gadzbi123/SimonSaysArduino/README.md

# SimonSaysArduino
Simple Arduino project

Download the movie from project
