gadzbi123/SimonSaysArduino/SimonSays.pptx

## Simon mówi

Projekt wykonany na mikroprocesorze

## Sposób komunikacja z użytkownikiem

- 4 guziki przyjmujące input gracza
- 4 diody wyświetlające kolejność przyciskania następnych klawiszy
- Reset do rozpoczęcia gry od nowa
- Wyświetlacz z prezentowanym wynikiem

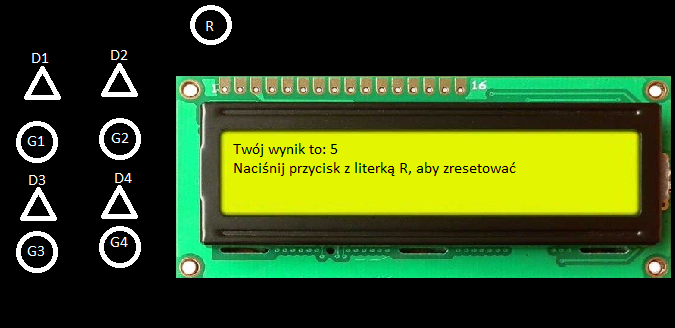
[picture p1: figure]

## Opis interfejsu wejścia/wyjścia

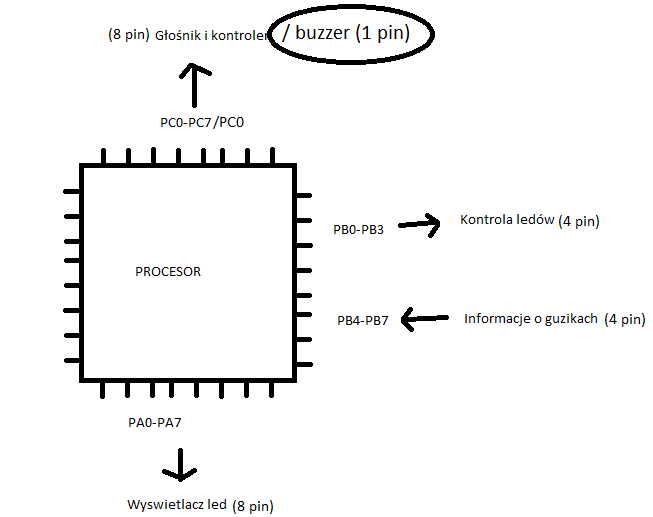
[picture p2: figure]

Najmniejsza ilość pinów potrzebna do wykonania projektu:
8 + 4 + 4 + 1 = 17 pinów

## Wybór mikrokontrolera i technologii

- AT tiny
- 8 KB flash
- Pin count >=17
Ostatecznie At tiny 826 lub AT tiny 48/88.
Technologia płytka drukowana.
Program Microchip Studio.

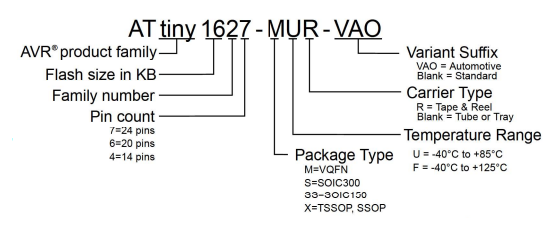
[picture p3: figure]
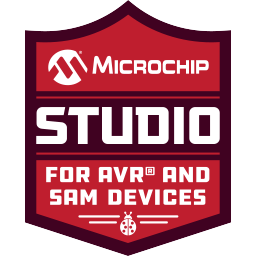
[picture p4: figure]
Microchip Studio for AVR® and SAM Devices | Microchip Technology

## Szacunkowy koszt

PROGRAMER
https://allegro.pl/oferta/programator-atmel-usbasp-usbisp-avr-isp-tasma-7638537342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

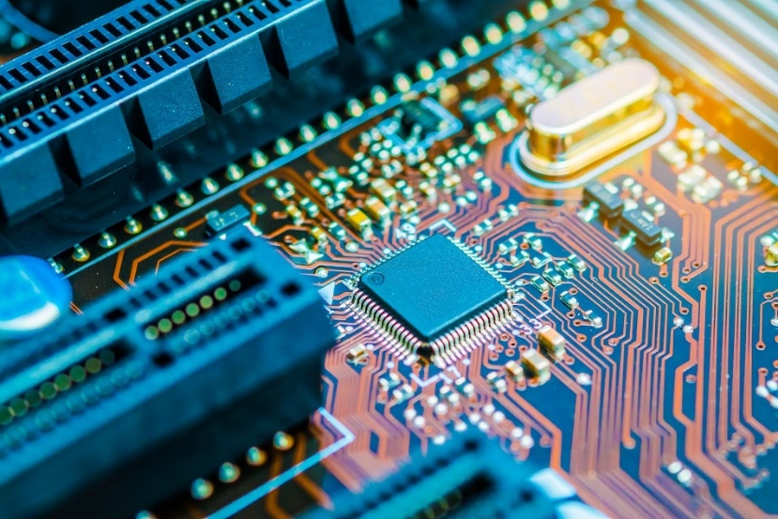
[picture p5: figure]
Could Thermal Analysis Help Develop PCB Design?

Mikroprocesor | 10 zł
Programator | 30 zł
Wyświetlacz led | 10 zł
Wydrukowanie PCB | 30-60 zł
Led, guziki, buzzer | 10 – 20 zł
Suma : | 90 – 130 zł

## Slide 6
