gadzbi123/SimonSaysArduino/board+schematic/attiny.brd

## EAGLE design board+schematic/attiny.brd (2024-04-27)

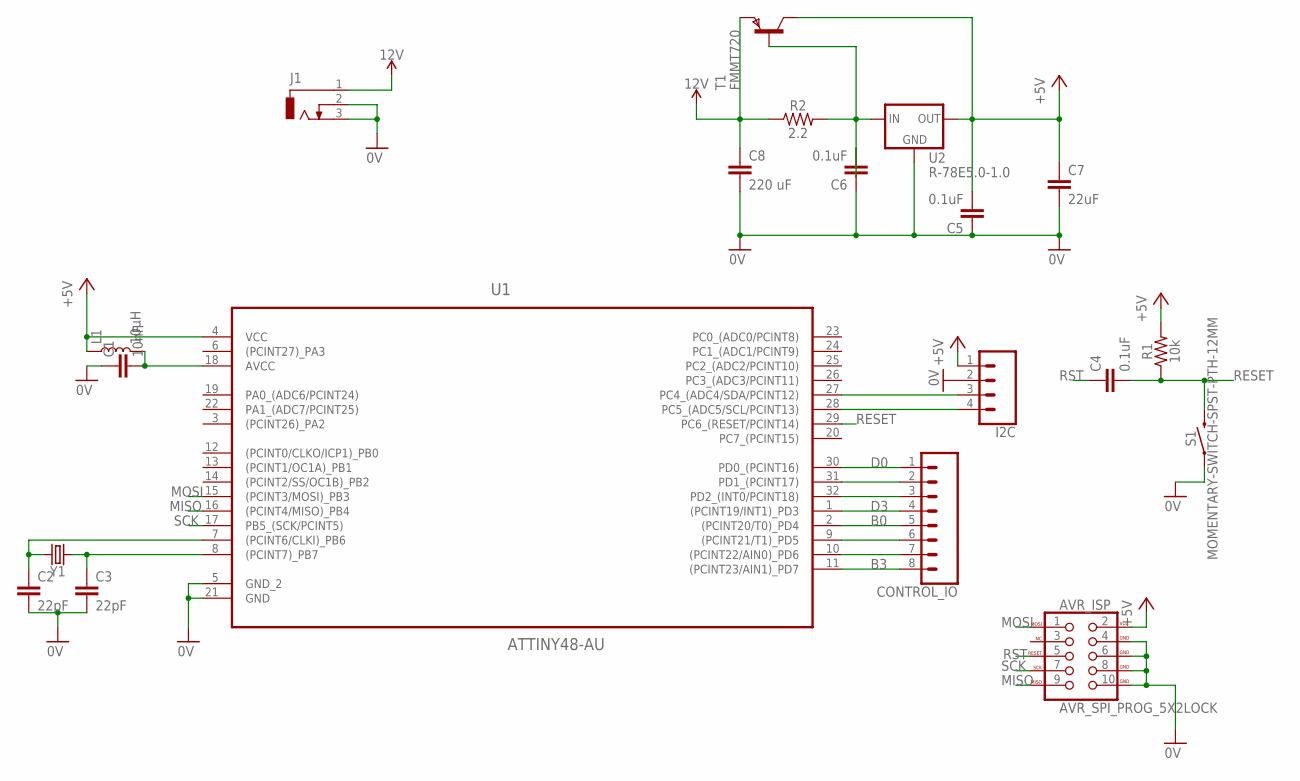
[picture p11: schematic attiny.sch]

Parts:
AVR_ISP: AVR_SPI_PROG_5X2LOCK; 2X5-SHROUDED_LOCK
C1: 10nF; CAP-PTH-10MM
C2, C3: 22pF; 0603
C4, C5, C6: 0.1uF; CAP-PTH-SMALL-KIT
C7: 22uF; 0805
C8: 220 uF; C7.5B5
CONTROL_IO: CONN_08"; 1X08
I2C: CONN_04PTH; 1X04
J1: DCJ0303
L1: 10μH; 0805
R1: 10k; AXIAL-0.3
R2: 2.2; 0603
S1: MOMENTARY-SWITCH-SPST-PTH-12MM; TACTILE_SWITCH_PTH_12MM
T1: FMMT720; SOT-23
U1: ATTINY48-AU; QFP80P900X900X120-32N
U2: R-78E5.0-1.0; DC-DC_CONVERTER_78XX
Y1: CRYSTALPTH-2X6; CRYSTAL-PTH-2X6-CYL

Connections:
0V: AVR_ISP.4 (GND), AVR_ISP.6 (GND), AVR_ISP.8 (GND), AVR_ISP.10 (GND), C1.1, C2.2, C3.2, C5.1, C6.1, C7.2, C8.2, I2C.2, J1.2, J1.3, S1.1, U1.5 (GND_2), U1.21 (GND), U2.GND
12V: C8.1, J1.1, R2.1, T1.2 (E)
+5V: AVR_ISP.2 (VCC), C5.2, C7.1, I2C.1, L1.1, R1.P$2 (2), T1.1 (C), U1.4 (VCC), U2.VOUT (OUT)
B0: CONTROL_IO.5, U1.2 ((PCINT20/T0)_PD4)
B3: CONTROL_IO.8, U1.11 ((PCINT23/AIN1)_PD7)
D0: CONTROL_IO.1, U1.30 (PD0_(PCINT16))
D3: CONTROL_IO.4, U1.1 ((PCINT19/INT1)_PD3)
MISO: AVR_ISP.9 (MISO), U1.16 ((PCINT4/MISO)_PB4)
MOSI: AVR_ISP.1 (MOSI), U1.15 ((PCINT3/MOSI)_PB3)
unnamed: C1.2, L1.2, U1.18 (AVCC)
unnamed: I2C.3, U1.27 (PC4_(ADC4/SDA/PCINT12))
unnamed: I2C.4, U1.28 (PC5_(ADC5/SCL/PCINT13))
unnamed: C2.1, U1.7 ((PCINT6/CLKI)_PB6), Y1.2
unnamed: C3.1, U1.8 ((PCINT7)_PB7), Y1.1
unnamed: C6.2, R2.2, T1.3 (B), U2.VIN (IN)
unnamed: CONTROL_IO.2, U1.31 (PD1_(PCINT17))
unnamed: CONTROL_IO.3, U1.32 (PD2_(INT0/PCINT18))
unnamed: CONTROL_IO.6, U1.9 ((PCINT21/T1)_PD5)
unnamed: CONTROL_IO.7, U1.10 ((PCINT22/AIN0)_PD6)
RESET: C4.2, R1.P$1 (1), S1.3 (2), U1.29 (PC6_(RESET/PCINT14))
RST: AVR_ISP.5 (RESET), C4.1
SCK: AVR_ISP.7 (SCK), U1.17 (PB5_(SCK/PCINT5))

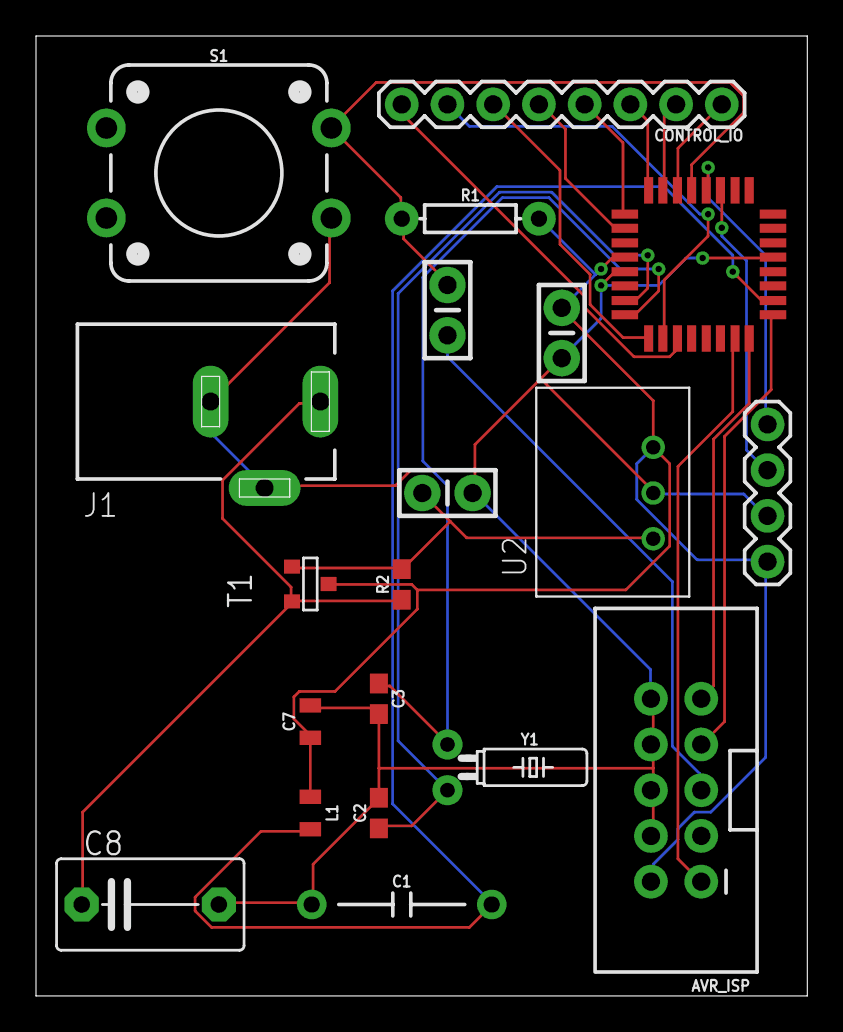
[picture p12: board attiny.brd from above]

Board: 2 copper layers, 42.9 x 53.3 mm, 20 parts (0 on the bottom side), 22 nets.
