gadzbi123/SimonSaysArduino/board+schematic/controller + diods + lcd.brd

## EAGLE design board+schematic/controller + diods + lcd.brd (2024-04-27)

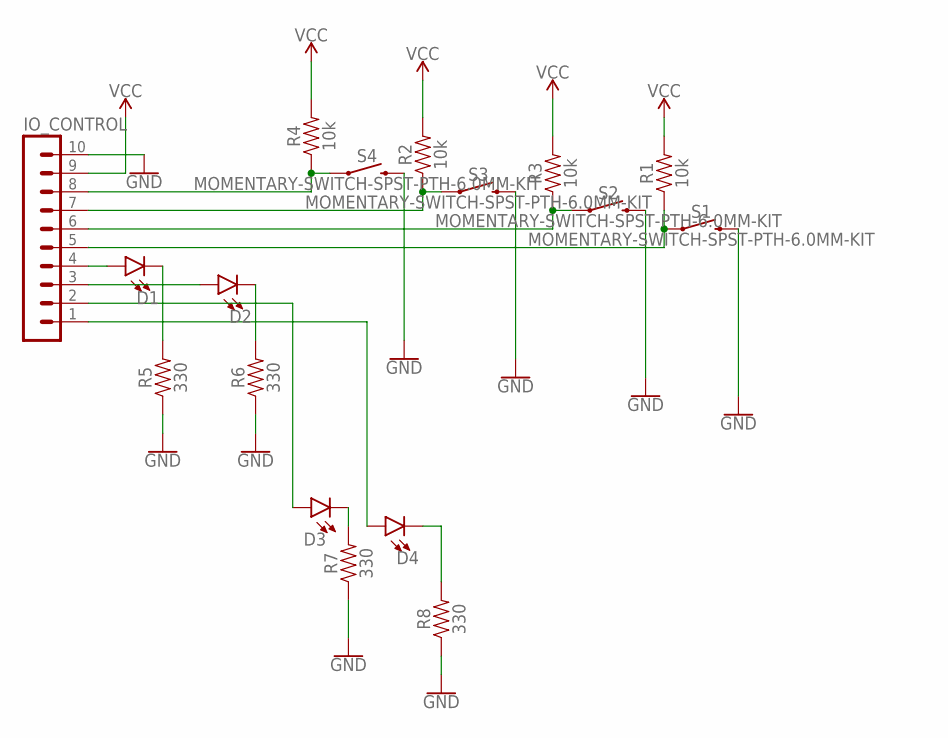
[picture p13: schematic controller + diods + lcd.sch]

Parts:
D1, D2, D3, D4: LED10MM; LED_10MM
IO_CONTROL: MA10-1
R1, R2, R3, R4: 10k; AXIAL-0.3-KIT
R5, R6, R7, R8: 330; AXIAL-0.3
S1, S2, S3, S4: MOMENTARY-SWITCH-SPST-PTH-6.0MM-KIT; TACTILE_SWITCH_PTH_6.0MM_KIT

Connections:
GND: IO_CONTROL.10, R5.P$1 (1), R6.P$1 (1), R7.P$1 (1), R8.P$1 (1), S1.3 (2), S2.3 (2), S3.3 (2), S4.3 (2)
unnamed: IO_CONTROL.6, R3.P$1 (1), S2.1
unnamed: IO_CONTROL.7, R2.P$1 (1), S3.1
unnamed: IO_CONTROL.8, R4.P$1 (1), S4.1
unnamed: D1.A, IO_CONTROL.4
unnamed: D1.C, R5.P$2 (2)
unnamed: D2.A, IO_CONTROL.3
unnamed: D2.C, R6.P$2 (2)
unnamed: D3.A, IO_CONTROL.2
unnamed: D3.C, R7.P$2 (2)
unnamed: D4.A, IO_CONTROL.1
unnamed: D4.C, R8.P$2 (2)
unnamed: IO_CONTROL.5, R1.P$1 (1), S1.1
VCC: IO_CONTROL.9, R1.P$2 (2), R2.P$2 (2), R3.P$2 (2), R4.P$2 (2)

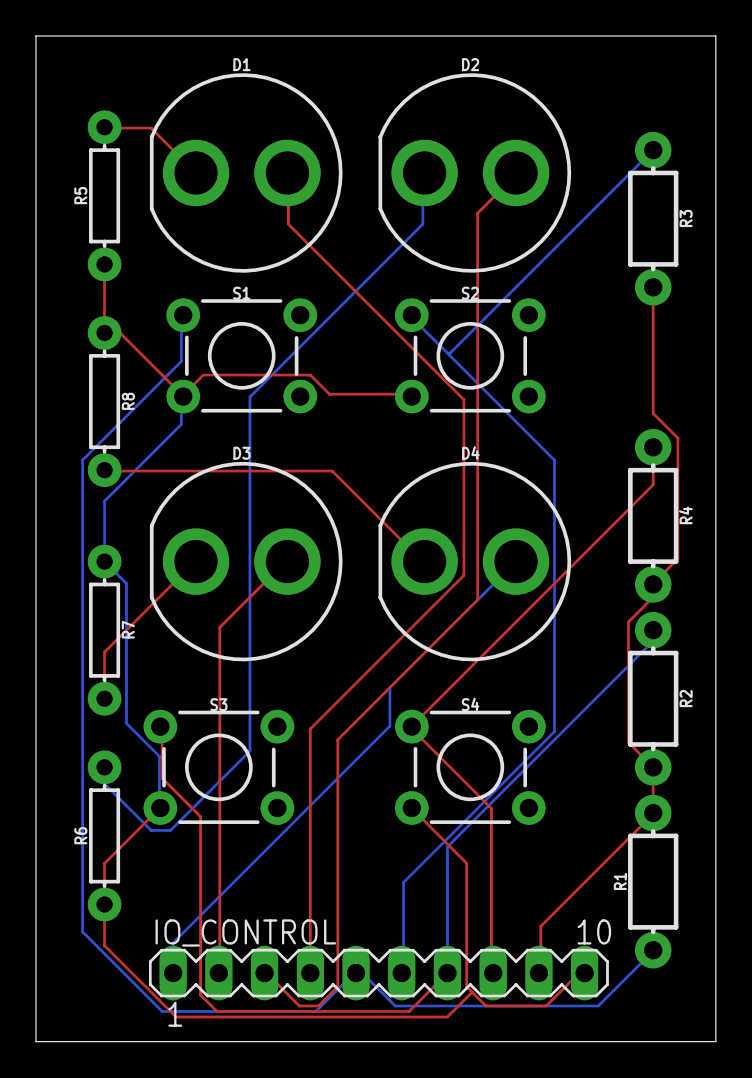
[picture p14: board controller + diods + lcd.brd from above]

Board: 2 copper layers, 37.8 x 55.9 mm, 17 parts (0 on the bottom side), 14 nets.
