gadzbi123/SimonSaysArduino/EAGLE/projects/Atmega2561-16AUR/atmega2561.sch

## EAGLE design EAGLE/projects/Atmega2561-16AUR/atmega2561.sch (2024-04-27)

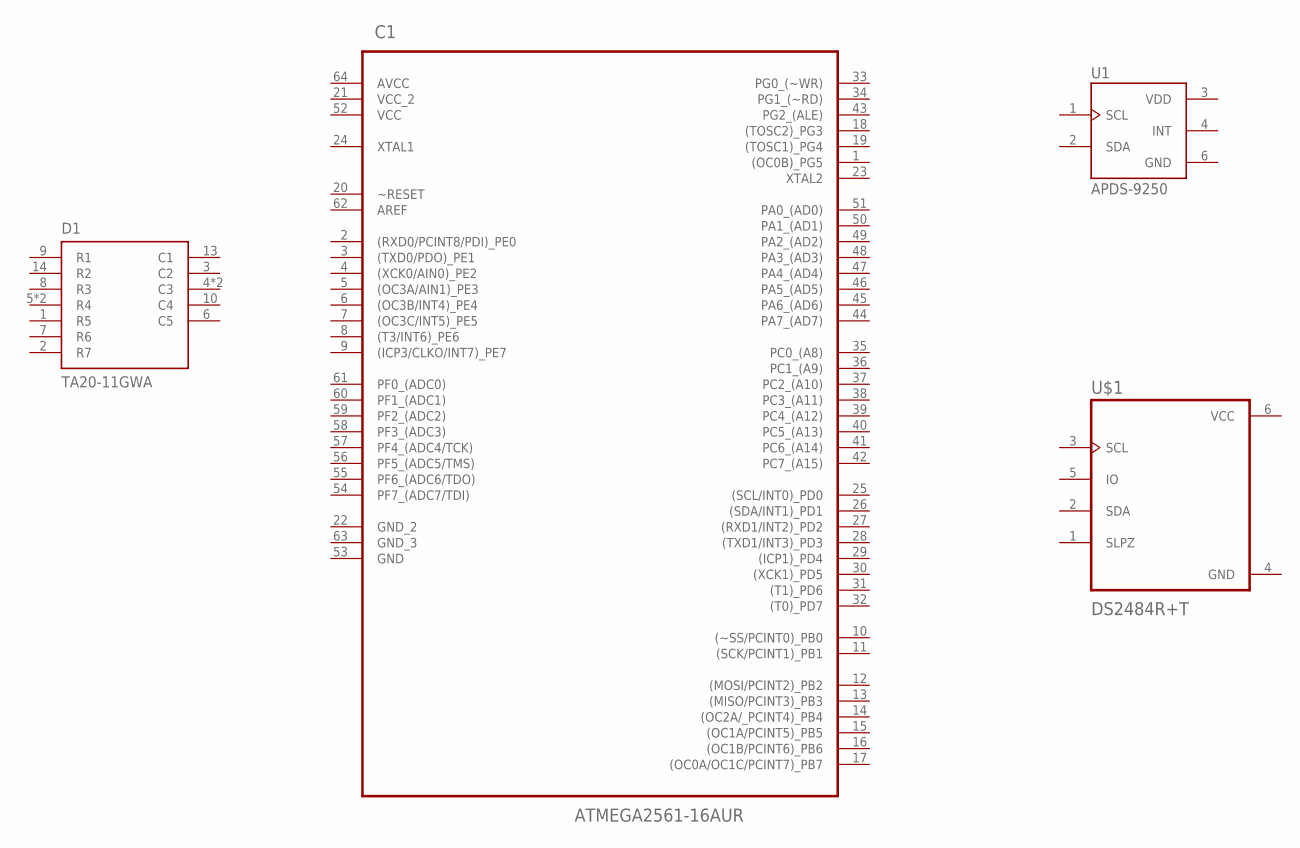
[picture p15: schematic atmega2561.sch]

Parts:
C1: ATMEGA2561-16AUR; QFP80P1600X1600X120-64N
D1: TA20-11GWA; LED_TA20-11GWA
U1: APDS-9250; SON65P200X200X75-6N
U$1: DS2484R+T; SOT95P280X145-6N
